microfarad-de/pi-ups/doc/pi-ups-schematic.pdf

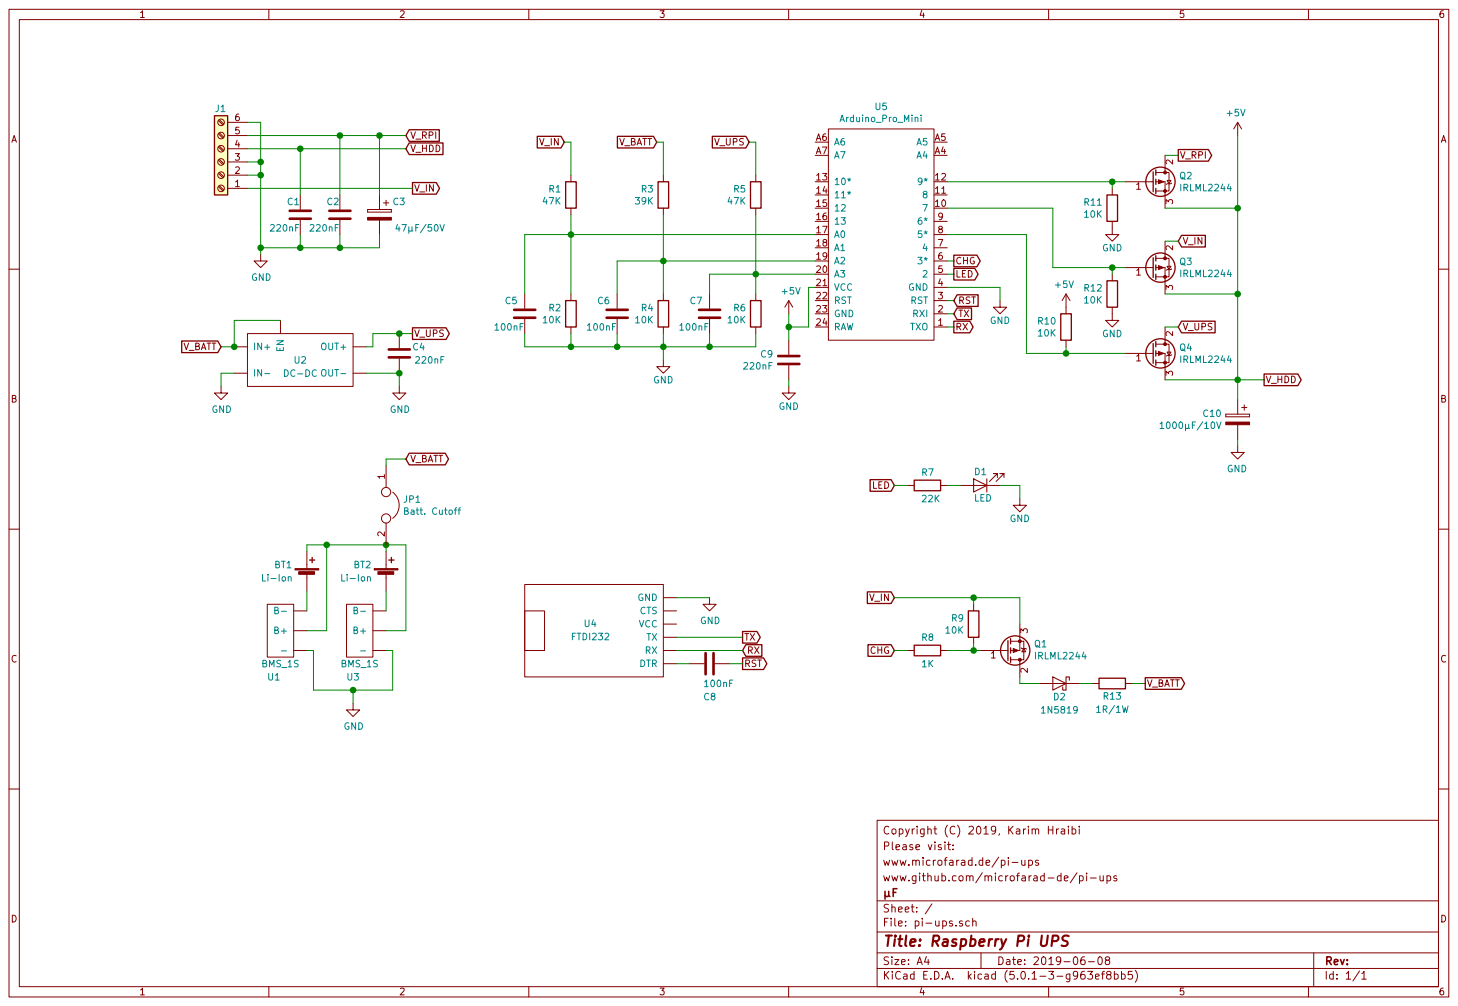
[picture p1: page 1]

3 | C1

www.microfarad.de/pi-ups Please visit: Copyright (C) 2019, Karim Hraibi

www.github.com/microfarad-de/pi-ups
File: pi-ups.sch Sheet: / µF

Id: 1/1 Title: Raspberry Pi UPS
