microfarad-de/pi-ups/(commit log)

2019-05-08 Added LED control class
2019-05-14 Added ADC module, setup test CLI
2019-05-17 Bringup: battery charger
2019-05-17 tweak battery charger
2019-05-22 Battery charger live test
2019-05-25 Shutdown routine runs as separate thread
2019-05-25 Increase PWM frequency, automatically clear errors
    [pi-ups.ino]
2019-05-26 Disable printing upon state transitions
2019-05-27 Bugfix: wrongly commented line
    [pi-ups.ino]
2019-05-31 Revert "Use \r\n for line endings"
    This reverts commit 93fd9ed3bc38205bcfb7082e176475ae17b6cc82.
    [pi-ups.ino]
2019-06-01 Refactor state string printing
2019-06-01 Bugfix in status string
    [pi-ups.ino]
2019-06-01 Do not disable test mode on battery low
2019-06-02 Reduced voltage precision in state string, updated schematic
2019-06-04 Status string: introduce hyseresis to voltage reading
2019-06-04 Stabilize battery percentage via hysteresis
    [pi-ups.ino]
2019-06-05 LiCharger: detect battery high and low voltage during charging
2019-06-05 LiCharger: bugfix - go back to standby state if charging disabled
2019-06-06 Introduce power saving
2019-06-06 Reduce V_batt_h hysteresis threshold, disable power save
2019-06-06 Enable power save, increase LiCharger update interval
2019-06-07 ADC: support non-contiguous pin assignments
2019-06-08 Increase I_full to 200mA
2019-06-08 Reduce LED blink interval in EXTERNAL state
2019-06-08 Led blinks twice whenever the "stat" command is received
2019-06-10 Upon state transition, print the last state into the status report
2019-06-10 Disable power save
2019-06-10 Increase number of averaged samples to 32
2019-06-10 Decrease averaged samples to 16
2019-06-13 Enter calibration state only from EXTERNAL. Reject calibration commands without values.
2019-06-14 Allow calibration when in error state
    [pi-ups.ino]
2019-06-14 Bugfix in DC-DC error detection
    [pi-ups.ino]
2019-06-14 Introduce delay before registering a DC-DC converter error
    [pi-ups.ino]
2019-06-14 Improve error hanling, DC-DC error gets cleared automatically
    [pi-ups.ino]
2019-06-15 Exit error state only after error codes have been logged.
    [pi-ups.ino]
2019-06-15 LiCharger: do not abort charging when below V_min
2019-06-19 Apply hysteresis to all ADC readings
2019-06-20 Increase ADC hysterrsis
2019-06-20 Disable ADC hysteresis during calibration
2019-06-20 Do not apply hysteresis to ADC readings, only apply to printed output.
2019-06-20 Update and rename ADC.cpp to Adc.cpp
2019-06-20 Update and rename ADC.h to Adc.h
2019-10-06 Implementing watchdog timer functionality
2019-10-06 RPi watchdog timer production version
2019-10-16 Increase battery voltage logging precision from 0.05V to 0.01V
2020-02-12 Reduced the battery voltage logging hysteresis to 0.015 V
2020-06-08 Switched all submodules to arduino-library Added VScode project files
2020-09-18 Reduced battery full voltage to 4.00 V
2026-07-07 Removed buggy last state print in brief status string Updated release script
    [pi-ups.ino]
2026-07-20 Configure all unused pins as INPUT_PULLUP to avoid excessive power draw due to toggling floating pins
    [pi-ups.ino]
